Sandeep271958/RC-Bionic-Butterfly/documentation/Wiring_Diagram_ESP32.jpg

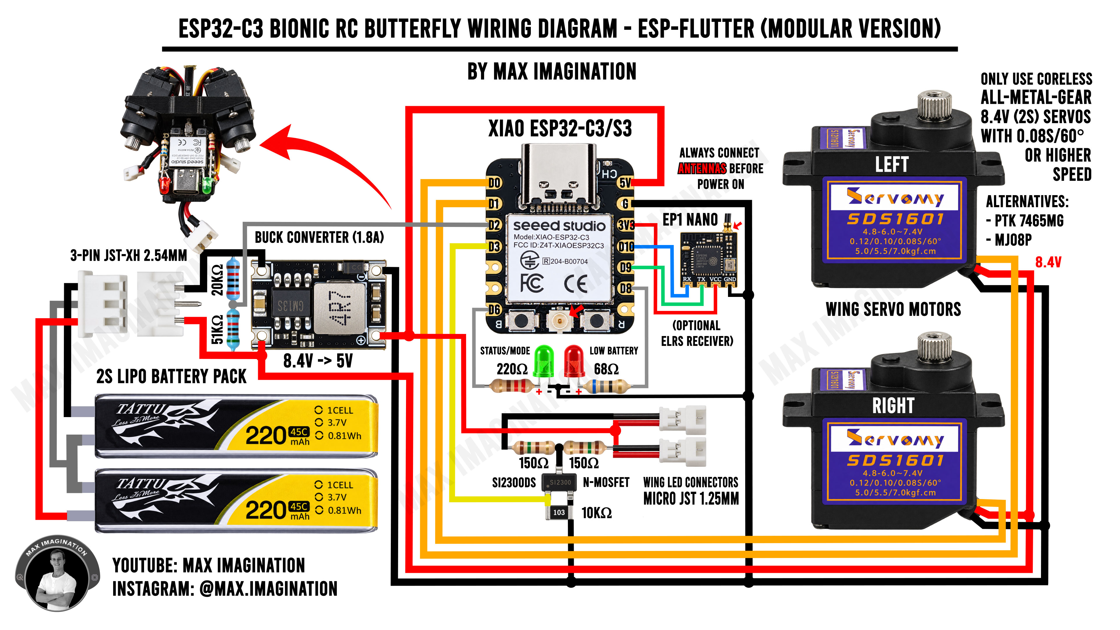
documentation/Wiring_Diagram_ESP32.jpg
