Sandeep271958/RC-Bionic-Butterfly/documentation/SDS1601_Servo_Datasheet.jpg

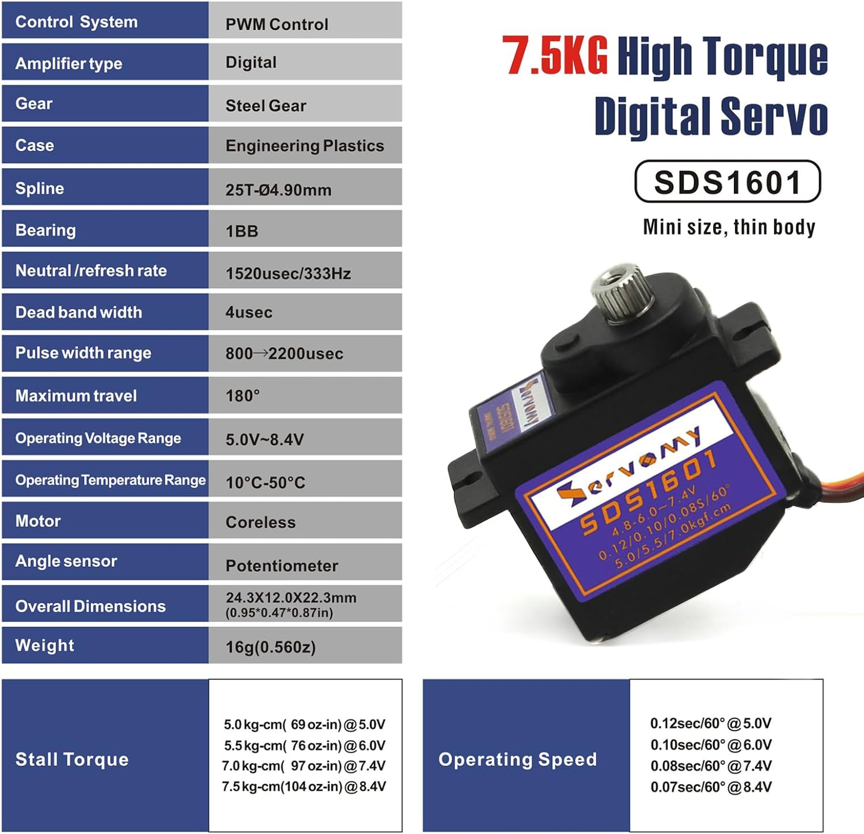
documentation/SDS1601_Servo_Datasheet.jpg
