Sandeep271958/RC-Bionic-Butterfly/documentation/Left_Wing_Blueprint.pdf

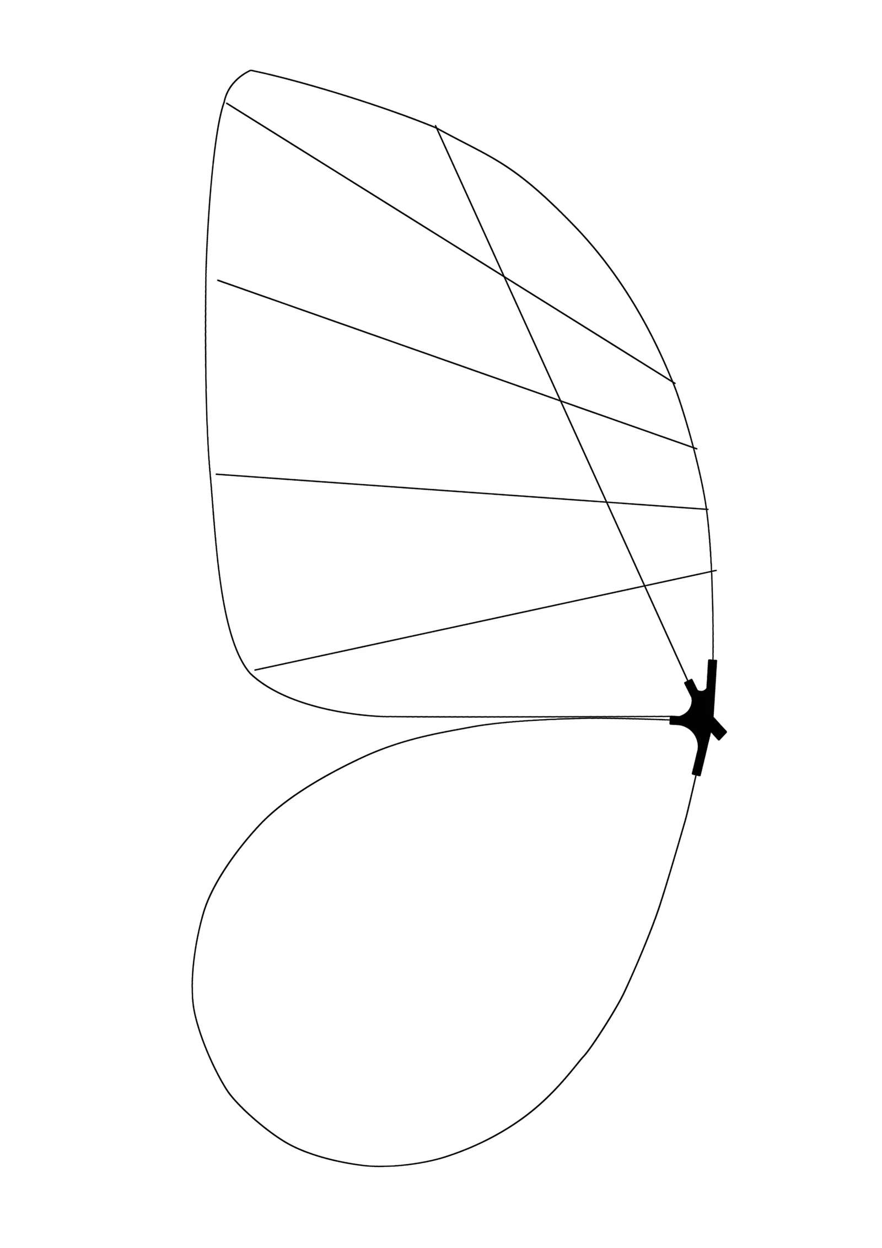
[picture p3: page 1]
