Sandeep271958/RC-Bionic-Butterfly/documentation/Right_Wing_Blueprint.pdf

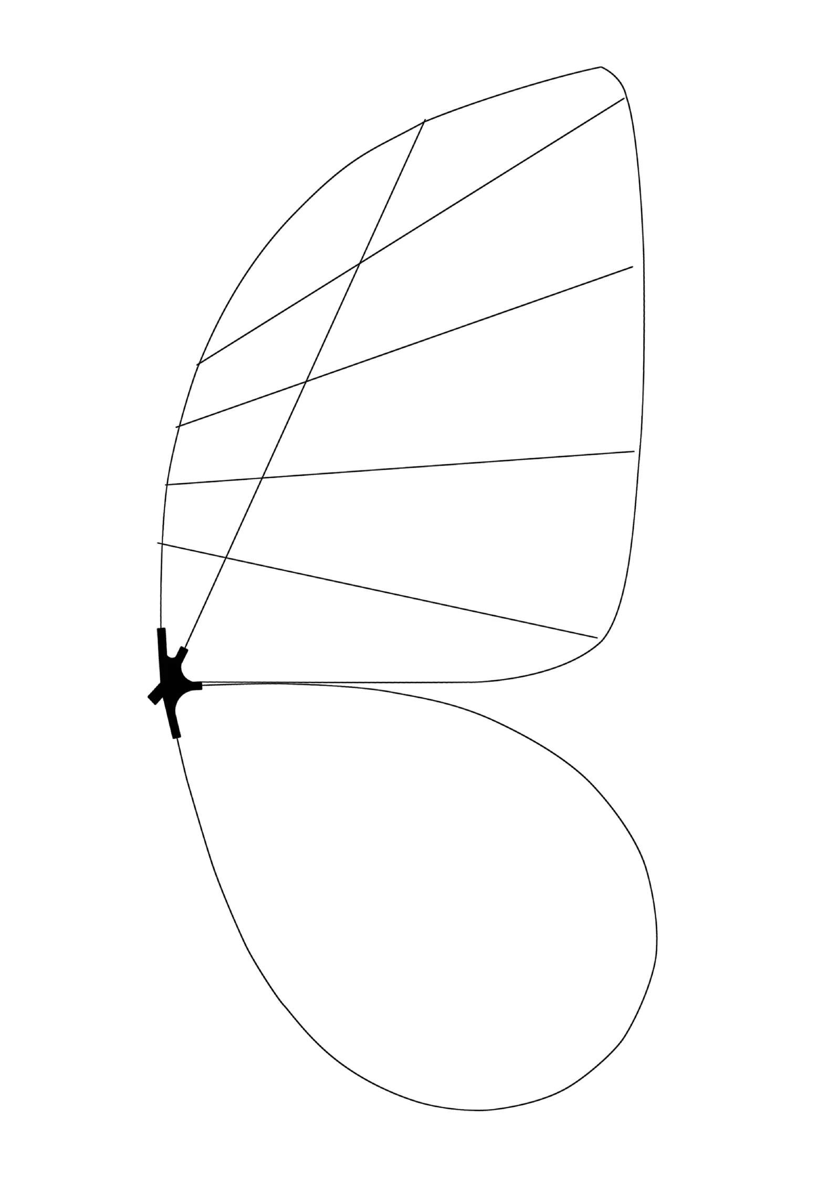
[picture p4: page 1]
