Sandeep271958/RC-Bionic-Butterfly/documentation/Flight_Controller_PCB_Schematic.jpg

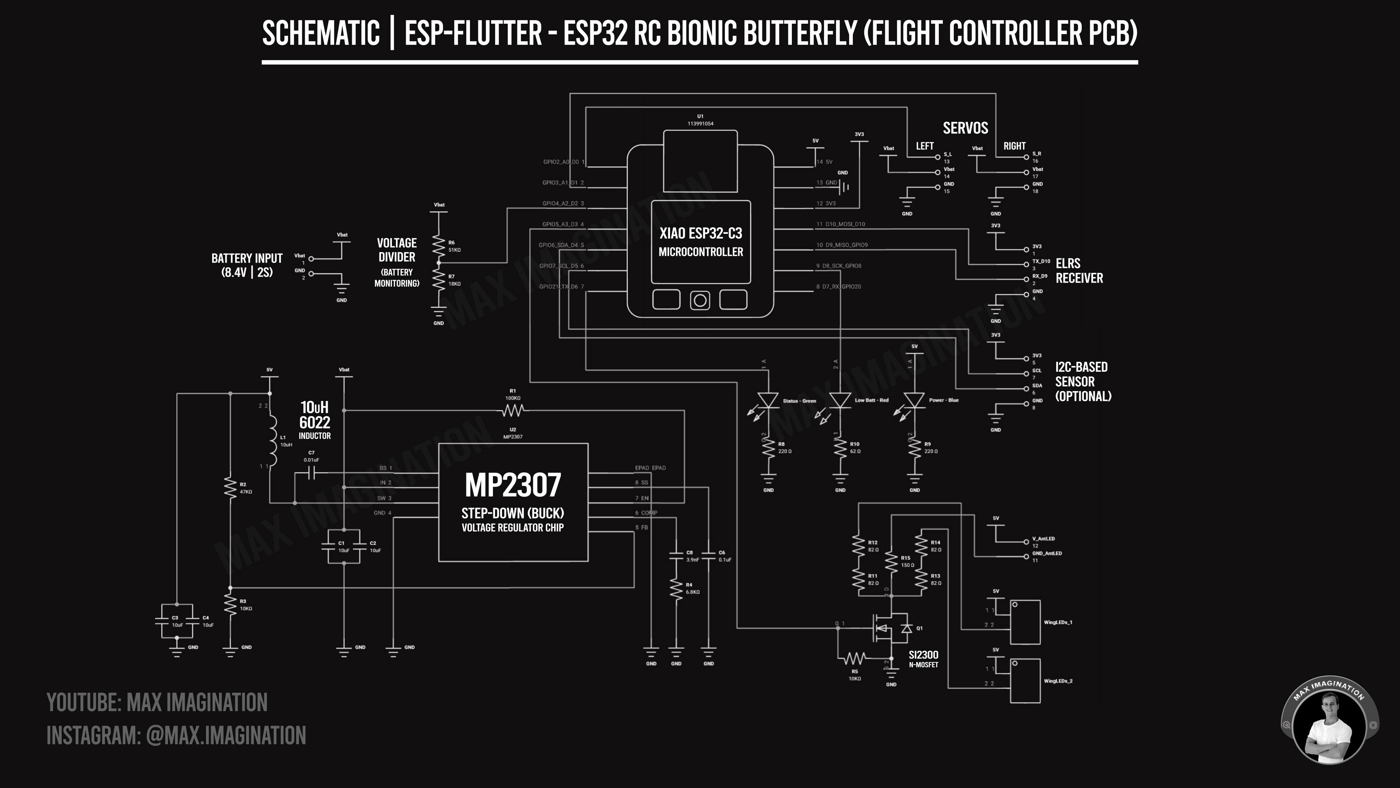
documentation/Flight_Controller_PCB_Schematic.jpg
