Sandeep271958/RC-Bionic-Butterfly/documentation/Rod_Length_and_Quantity_Chart.jpg

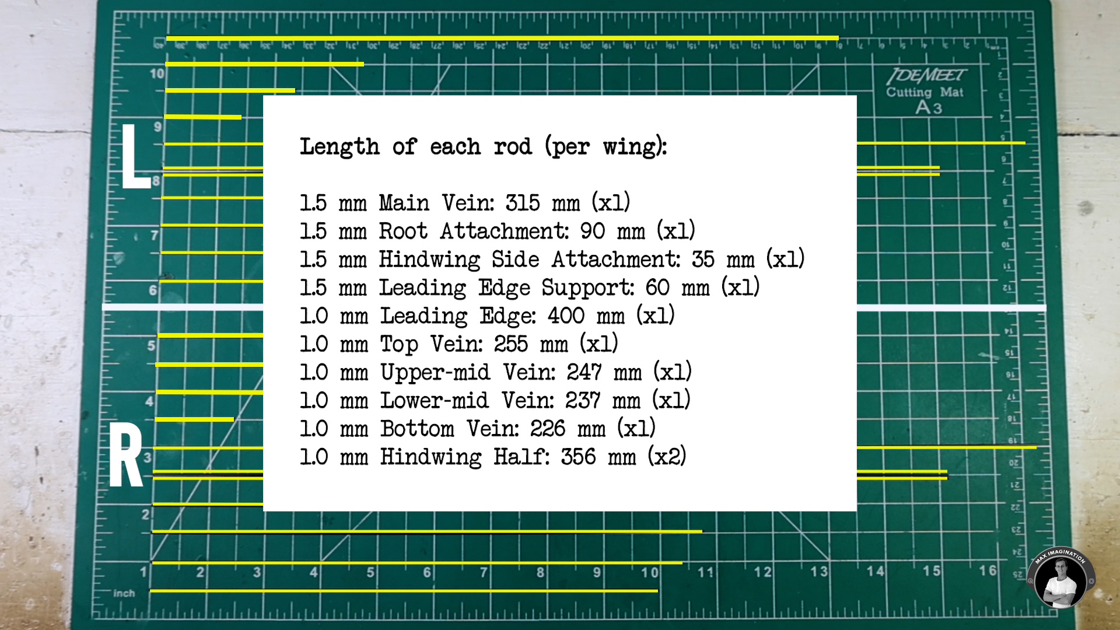
documentation/Rod_Length_and_Quantity_Chart.jpg
