Sandeep271958/RC-Bionic-Butterfly/documentation/Wing_Carbon_Rod_Thickness_Schematic.png

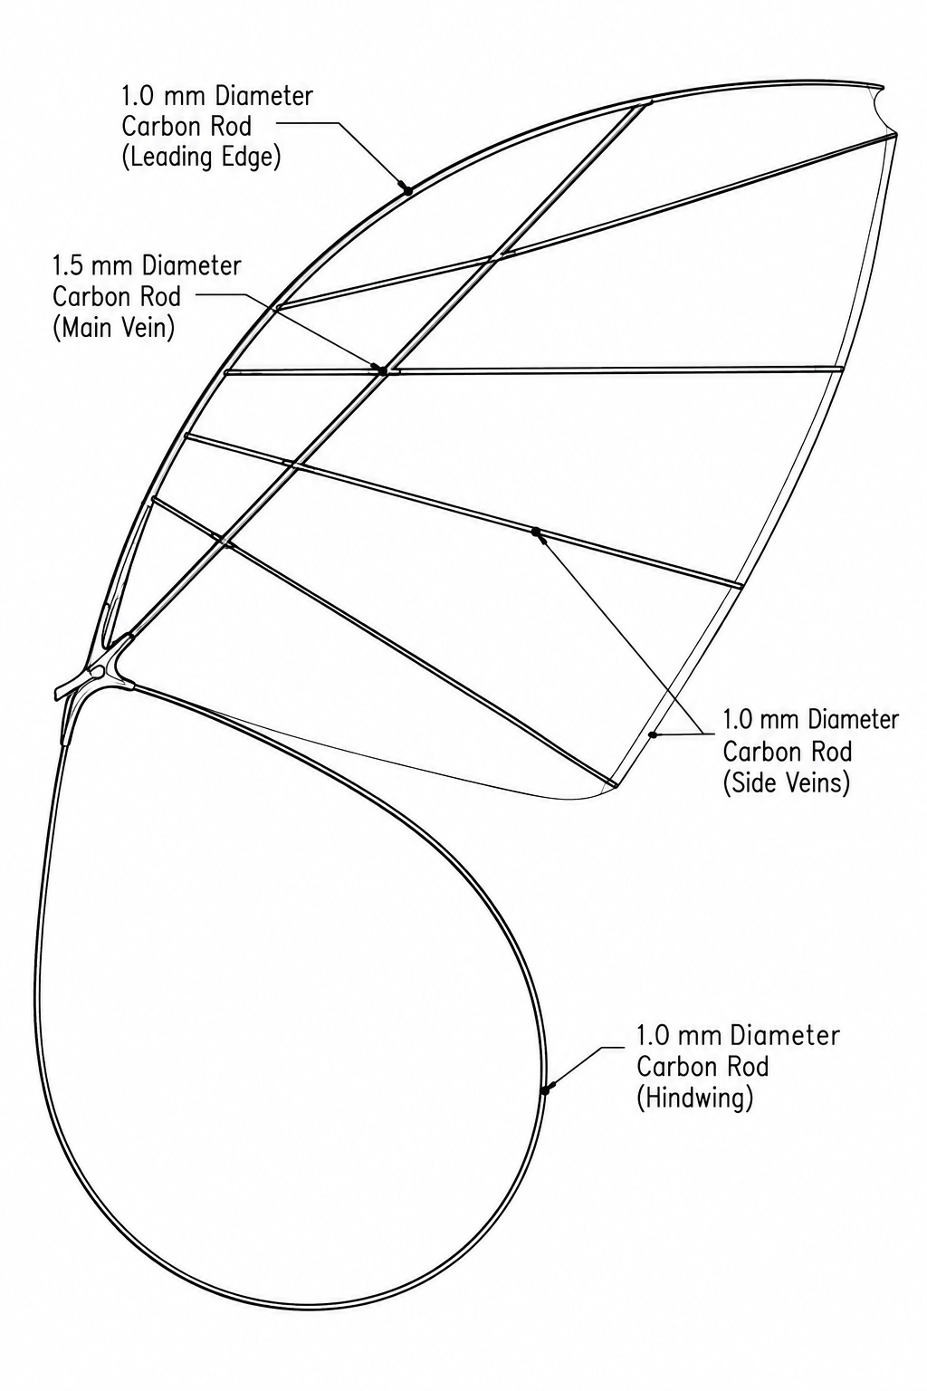
documentation/Wing_Carbon_Rod_Thickness_Schematic.png
