Sandeep271958/RC-Bionic-Butterfly/hardware/ARMV5_Left_Mirrored.stl

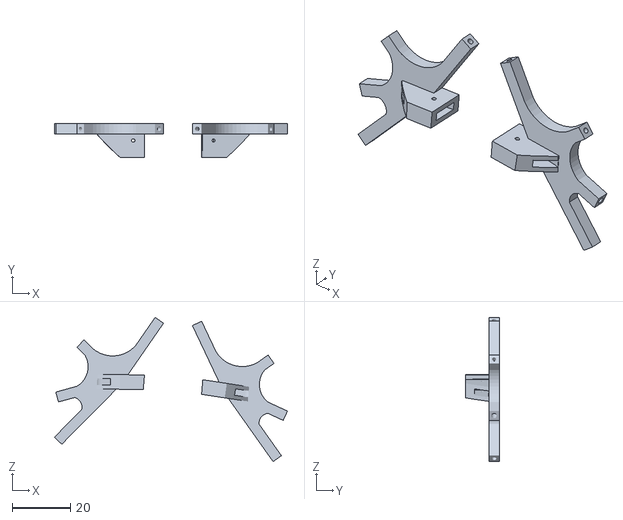
[picture p8: CAD file, 2026-11-02]
hardware/ARMV5_Left_Mirrored.stl
79.7 x 11.5 x 49.3
