Sandeep271958/RC-Bionic-Butterfly/hardware/FC_Mount_V5.stl

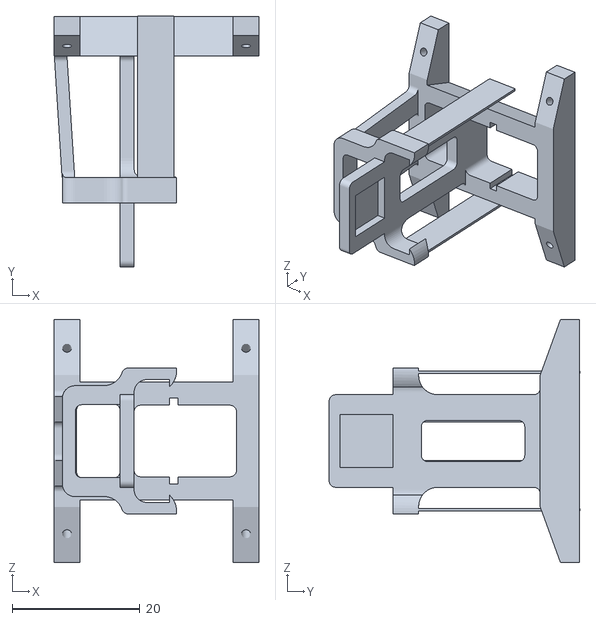
[picture p9: CAD file, 2026-11-02]
hardware/FC_Mount_V5.stl
32.0 x 39.2 x 38.0
