Sandeep271958/RC-Bionic-Butterfly/(list of files, cad)

Other CAD files:
hardware/ARMV5_Right.stl
