Sandeep271958/RC-Bionic-Butterfly/documentation/Print_Settings.jpg

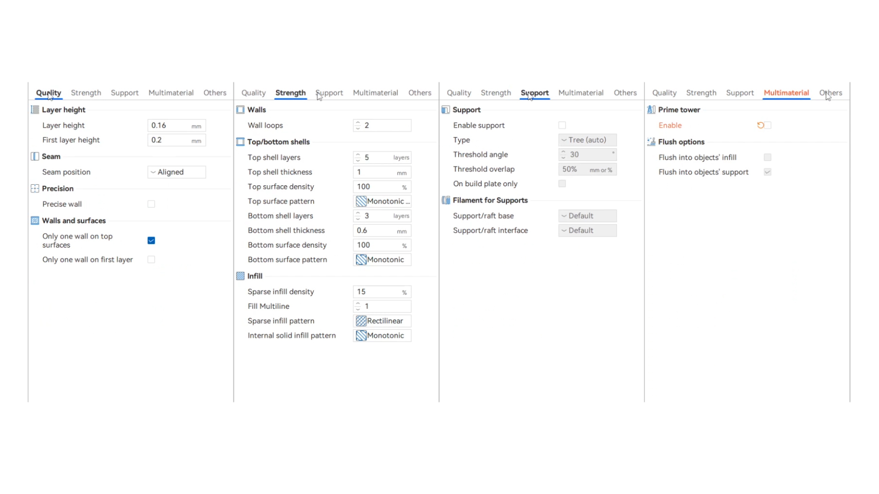
documentation/Print_Settings.jpg
