Sandeep271958/RC-Bionic-Butterfly/(commit log)

2026-11-02 Initial commit: Complete RC Bionic Butterfly build files, enhanced flight firmware v2.0, and scratch build manual
    [3.STL, ARMV5.STL, FC Mount V5.STL]
2026-11-02 feat: Integrate Max Imagination ESP-FLUTTER innovations (differential-amplitude steering, turn lift boost, ESP32-C3 web app, night LEDs)
2026-11-02 feat: Fully adopt ESP-FLUTTER architecture, vector wing blueprints, cut list chart, verified slicer profiles, and upstream firmware
2026-11-02 refactor: Consolidate project architecture around ESP32 with dual Smartphone Web App + PPM RC control, pre-mirrored 3D hardware, and official documentation
    [ARMV5_Left_Mirrored.stl, ARMV5_Right.stl, FC Mount V5.STL, FC_Mount_V5.stl]
